ahmeteminaydin/comet/src/g5.js

G.peak = {name:"Peak-hold / pulse height (extra)", group:"Analog chain", k:"ana",
 summary:"The peak-hold is an extra feature that measures how big each muon pulse is. It captures the highest voltage of the shaped AFE pulse and holds it long enough for the microcontroller's ADC to read it. A histogram of these heights shows the Landau distribution, the characteristic shape of energy loss by a charged particle in a thin layer.",
 io:["The shaped AFE pulse from the slow branch","A held voltage equal to the pulse peak, read by the MCU ADC as a 12-bit code (hA or hB)"],
 how:[
  "Why pulse height is interesting. Muons crossing 1 cm of plastic do not all lose exactly 2 MeV. Most lose close to the most probable value, but now and then one knocks out an energetic electron and loses much more. The resulting distribution has a peak and a long tail toward high energy, called the Landau distribution. Seeing this shape proves that the counted pulses really come from minimum ionizing particles, and the position of the peak tracks the SiPM gain over time.",
  "How a peak detector works. An op-amp charges a small capacitor through a diode. While the input rises, the op-amp charges the capacitor to follow it. When the input falls, the diode blocks, so the capacitor keeps the highest voltage reached. A buffer amplifier copies the capacitor voltage to the ADC without draining it.",
  "Forgetting old pulses. A plain peak detector keeps the largest pulse since it was last emptied, which could be an unrelated single from seconds ago. The baseline therefore puts a bleed resistor across the capacitor so the held voltage decays with a time constant of about 20 µs. Singles arrive tens of milliseconds apart, so an old pulse has fully decayed before the next event, while the current pulse loses only a few percent in the 1 µs before it is sampled. Because the sampling delay is always the same, that small loss is the same for every event and is removed by calibration.",
  "Timing. The coincidence latch tells the microcontroller that an event happened. The firmware waits a fixed 1 µs for the shaped pulse to reach its peak, converts both channels with the ADC, and then empties the capacitors by raising PEAK_RST for at least 200 ns. The sequence takes a few microseconds, which is negligible at about 12 events per minute.",
  "Why the reset goes through a resistor. SW1 drains C20 through R18 (100 Ω) rather than shorting it. If SW1 shorted C20 directly, U10 would try to pull the hold node back up to its input, push its full output current (tens of milliamps) through D1 into the switch, and end up stuck at its positive limit. When the switch opened, the saturated op-amp would dump extra charge into C20 and the next reading would start too high: in simulation the ADC then read 0.78 V instead of the 0.30 V baseline. With R18, C20 falls to the baseline within about 50 ns, U10 simply holds it there with about 3 mA, and nothing overshoots when the switch opens."],
 conn:[["From","The AFE output through the CR-RC shaping stage."],["To","An MCU ADC input (ADC ← peak A and ADC ← peak B on the schematic)."],["Control (optional)","A reset line from an MCU GPIO pin to an analog switch across the hold capacitor."]],
 specs:["Analog peak-hold or fast sampling to reconstruct the Landau distribution (extra feature)","Held value a fixed few percent below the peak (about −6 % in simulation, removed by calibration), linear for pulses up to about 1.4 V above the 0.3 V baseline","Decay time constant ≈ 20 µs so old pulses are forgotten","Sampled at a fixed delay of ≈ 1 µs after the coincidence latch; reset back to the baseline within 200 ns"],
 steps:[
  ["Simulate the peak detector","In LTspice, build the op-amp, Schottky diode (BAT54), hold capacitor (start with 470 pF), bleed resistor and buffer, and feed it the shaped AFE pulse. Check that the value 1 µs after the pulse is a fixed few percent below the pulse peak for pulses up to about 1.4 V above the 0.3 V baseline. Larger pulses pass the OPA356's input limit (1.8 V on a 3.3 V supply) and clip, which only affects the far end of the Landau tail."],
  ["Choose the capacitor and bleed resistor","Pick the capacitor and resistor so that their product is about 20 µs, for example 470 pF and 43 kΩ. Check in simulation that the capacitor still charges fully during the rising edge of the pulse; if not, use a smaller capacitor and a larger resistor."],
  ["Add the reset switch","Place a TS5A3159 analog switch from the hold capacitor to ground through R18 = 100 Ω, and drive it from the PEAK_RST pin of the MCU with a 100 kΩ pull-down (R39) so it stays open while the MCU is in reset. Power the switch's V+ pin from +3V3 so the 3.3 V logic line can drive it. The firmware can then empty the capacitor right after reading, which helps when two events come close together."],
  ["Connect and time the ADC","Wire each buffer output to an ADC input. In the coincidence interrupt, wait a fixed 1 µs after the latch, convert both channels, then raise PEAK_RST for at least 200 ns. Use exactly the same delay for every event."],
  ["Calibrate","Inject pulses of known amplitude at the AFE input and record the ADC codes. Fit a straight line from code to amplitude and use it to label the histogram axis."],
  ["Build the histogram","In the GUI, histogram hA and hB for all coincidence events. After a few thousand events the Landau shape with its long tail should appear."]],
 parts:[["Op-amp","OPA356 (U10) on +3V3_A","Charges the hold capacitor quickly; on the 3.3 V analog rail it can never drive the ADC above 3.3 V."],
  ["Diode","BAT54 Schottky","Low forward voltage and fast switching."],
  ["Hold network","470 pF C0G capacitor with a 43 kΩ bleed resistor","Holds the peak for about 20 µs and then forgets it."],
  ["Reset","TS5A3159 analog switch, R18 100 Ω, R39 100 kΩ pull-down","Empties the capacitor on command without fighting U10."],
  ["Buffer","OPA356 (U11) as a unity-gain buffer","CMOS inputs with picoamp bias current, so it does not drain the capacitor."]],
 test:[["Linearity","Inject pulses of increasing size at the AFE input. Reading minus baseline against pulse height should be a straight line up to about 1.4 V at the shaper output."],
  ["Reset","Trigger a reading followed by PEAK_RST. Right after the reset the ADC must read the 0.30 V baseline, not a value above it."],
  ["Old pulses forgotten","Fire a large test pulse, then a small one 1 ms later. The second reading must match the small pulse, not the large one."],
  ["Landau shape","After about 2,000 muon events, the histogram should show a clear peak and a long tail toward large heights, with noise only at the very low end."]],
 pitfalls:[["Holding the wrong pulse","Without the bleed resistor or a reset, the circuit keeps the largest pulse since the last reset, which may be an unrelated single. Always make it forget old pulses."],
  ["Leakage","Leakage in the diode and input current of the buffer make the held voltage drift. Choose low-leakage parts and always sample at the same delay."],
  ["Pile-up","If two pulses arrive within a few microseconds, the measured height is wrong. The firmware can flag events where a second single arrived during the hold time."]],
 terms:[["Landau distribution","The asymmetric distribution of energy lost by a fast charged particle in a thin layer: a peak with a long tail toward high energy."],
  ["Peak detector","A circuit that follows a rising signal and holds its maximum."],
  ["Droop","The slow fall of a held voltage caused by leakage or a bleed resistor."]]};

G.thr = {name:"Threshold DAC", group:"Analog chain", k:"ana",
 summary:"The threshold DAC sets the voltage each comparator compares the pulse against. A threshold that is too low lets noise and dark counts through, and one that is too high throws away real muons. Because the microcontroller sets it, the team can scan thresholds and set the two channels independently.",
 io:["A threshold value from the MCU over I²C","Two reference voltages, one per comparator, equal to the AFE baseline plus the chosen threshold"],
 how:[
  "What the threshold does. The comparator outputs a logic pulse only while the AFE output is above the threshold voltage. Dark counts give about 1.6 mV per photoelectron at TP2 (a few millivolts when crosstalk fires neighbouring cells), gammas give anything from a few to hundreds of millivolts, and a typical muon gives about 0.23 V (simulation of the baseline design). The threshold should sit well above the dark-count level but well below the muon pulses.",
  "Choosing the value. In the baseline one photoelectron is about 1.6 mV at TP2, so a threshold of 120 mV above the baseline corresponds to roughly 75 photoelectrons. That is far above dark-count pile-up and about half of a typical muon pulse. The light yield of 140 photoelectrons is only an estimate, so the final value comes from a threshold scan: you measure the count rate at many thresholds and choose a point on the flatter part of the curve, where small threshold changes barely change the rate.",
  "Threshold relative to the baseline. The AFE baseline sits at about 0.3 V, so the comparator reference is the baseline plus the threshold, for example 0.300 + 0.120 = 0.420 V (DAC code 840). The firmware stores thresholds as millivolts above the baseline and adds the baseline when it sets the DAC.",
  "Why a DAC. A quad DAC (MCP4728) gives four outputs from one small chip: threshold A, threshold B, a spare, and the bias setting (VOUTD, halved onto the LT3482's CTRL pin). It has a built-in 2.048 V reference, so each step is 0.5 mV. It can also keep codes in its EEPROM, but from the factory these are 0: after power-up the thresholds sit at 0 V, below the baseline, so the comparators stay on, and the bias is off until the firmware writes its codes."],
 conn:[["From","The MCU over I²C (MCP4728 default address 0x60)."],["To","The − input of each comparator, through a 1 kΩ / 100 nF RC filter."],["Shares the chip with","The bias setting used by the temperature compensation (DAC channel D → R22/R36 → LT3482 CTRL)."]],
 specs:["Adjustable comparator threshold in each module (spec)","Step size 0.5 mV (12-bit with the 2.048 V internal reference)","Thresholds A and B set independently","Settings kept in the DAC's memory and in MCU flash"],
 steps:[
  ["Prototype with potentiometers","For the first prototype, use a 10-turn trimmer potentiometer per channel between 3.3 V and ground, with the wiper filtered by 1 kΩ and 100 nF. This lets you test the analog chain before any firmware exists."],
  ["Wire the DAC","On the baseboard, place the MCP4728 near the comparators, power it from 3.3 V, connect SDA and SCL to the MCU I²C bus with 4.7 kΩ pull-ups, and select its internal 2.048 V reference. Output A goes to comparator A, output B to comparator B, and output D to the bias CTRL divider. Tie LDAC̅ low so the outputs update as soon as each write finishes."],
  ["Filter at the comparator","Put a 1 kΩ resistor and a 100 nF capacitor right at each comparator's − input, so digital noise picked up on the DAC line cannot move the threshold."],
  ["Write the commands","Add firmware commands such as THR A 120 and THR B 120, in millivolts above the baseline. The firmware adds the baseline (measured at start-up or the design value of 0.3 V), converts to a DAC code and writes it. Save the values to flash."],
  ["Run a threshold scan","For each channel, step the threshold from 20 mV to 800 mV in roughly 20 mV steps and count singles for 30 seconds at each step. Plot the rate against threshold with a logarithmic rate axis. You will see a steep fall at low thresholds (noise and dark counts), a gentler slope (gammas), and a shoulder where the muon pulses sit. Choose a threshold just above the steep part, and set the two channels so they give similar singles rates."],
  ["Repeat after changes","Repeat the scan whenever the bias, a SiPM or the optical coupling changes."]],
 parts:[["DAC","Microchip MCP4728 quad 12-bit DAC","Four outputs, internal reference and settings memory in one small chip."],
  ["Prototype","10-turn trimmer potentiometers","Quick bring-up without firmware."],
  ["Filter","1 kΩ resistor and 100 nF capacitor per channel","Keeps the threshold quiet at the comparator."],
  ["I²C pull-ups","2 × 4.7 kΩ to 3.3 V","Needed once for the whole I²C bus."]],
 test:[["DAC output","Command several thresholds and measure the comparator − pin with a multimeter. It should equal baseline plus threshold within about 2 mV."],
  ["Threshold scan shape","The scan should show a steep fall and then a much flatter region. If the rate never flattens, there is a noise problem or a light leak."],
  ["Channel balance","At the chosen thresholds, the singles rates of A and B should agree within about 20 %."]],
 pitfalls:[["Ground offsets","If the DAC and the comparator use different ground points, a few millivolts of ground difference shift the threshold. Return both to the same analog ground."],
  ["Forgetting the baseline","Setting the DAC to 120 mV when the baseline is 300 mV puts the reference below the baseline, so the comparator stays on permanently. Always add the baseline."],
  ["Threshold on the steep part","A threshold on the steep part of the scan makes the rate very sensitive to small gain changes. Stay on the flatter part."]],
 terms:[["Threshold scan","A measurement of count rate against threshold, used to choose the operating point."],
  ["DAC","Digital-to-analog converter, which turns a number from the MCU into a voltage."],
  ["Plateau","The flatter region of a threshold scan, where the rate changes slowly."]]};
