ahmeteminaydin/comet/src/g7.js

G.coinc = {name:"Coincidence logic (AND + latch)", group:"Timing logic", k:"dig", tool:"acc",
 summary:"The coincidence logic decides whether both modules fired at the same time. An AND gate combines the two stretched pulses, and a flip-flop catches its output and holds it until the microcontroller has read it. Every event that reaches the PC as an EVT line starts here.",
 io:["Stretched pulses A and B, 50 ns each","A latched coincidence signal for the MCU's timer input (TP5)"],
 how:[
  "The AND gate. A 74LVC1G08 outputs 3.3 V only when both inputs are high. Its inputs are the two 50 ns stretched pulses, so its output goes high only when the pulses overlap, which means the two slabs fired less than 50 ns apart. The gate adds a delay of only a few nanoseconds.",
  "Why a latch is needed. If the two pulses only just overlap, the AND output can be a few nanoseconds long. The microcontroller could miss such a short pulse, and it needs time to respond anyway. The AND output therefore clocks a 74LVC1G74 D flip-flop whose D input is tied high: on the rising edge, Q goes high and stays high. Q is wired to a timer input-capture pin on the MCU, which records the exact time, and the firmware clears the flip-flop through its CLR pin once it has handled the event.",
  "Dead time. While the flip-flop is set and the firmware is handling the event, another coincidence would be missed. The firmware handles an event in well under 50 µs and coincidences arrive about every 5 seconds, so the chance of missing one is about 1 in 100,000.",
  "Accidental coincidences. Two unrelated hits, one in each slab, can fall into the window by chance. Their rate is R_acc = (w_A + w_B) × R_A × R_B. With 40 Hz singles in each channel and a 100 ns window this is about 0.01 per minute, roughly a thousand times smaller than the muon rate. It is still subtracted in the analysis (see the data logger guide), and the calculator below shows how quickly it grows if the singles rates rise.",
  "Singles counting. Each stretched pulse also goes to a hardware counter in the MCU. These singles counts are needed for the accidental correction and help to spot light leaks and threshold problems."],
 conn:[["From","Stretched pulses A and B (TP4)."],["To","An MCU timer input-capture pin and its interrupt (CAPTURE ← coinc, TP5)."],["Control","An MCU GPIO pin to the flip-flop's CLR input, and an optional MCU test-pulse output into both channels."]],
 specs:["Hardware coincidence with a window ≤ 100 ns (spec)","Accidental rate < 0.1 /min in horizontal or non-aligned orientation (spec)","Gate and latch delays of a few ns","Latch cleared by the MCU after every event, with a timeout as a safety net"],
 steps:[
  ["Place the gate and latch","Put the 74LVC1G08 and the 74LVC1G74 close together between the two stretchers, powered from 3.3 V with a 100 nF capacitor at each chip. Make the traces from the two stretchers to the AND inputs about equal in length."],
  ["Wire the latch","Connect the AND output to the flip-flop's clock input, tie D and PRE̅ (preset, active low) to +3V3, connect Q to an MCU timer channel set up for input capture (TIM2), and connect CLR̅ (active low) to the LATCH_CLR pin of the MCU with a 10 kΩ pull-up (R37). The pull-up keeps the latch armed while the MCU's pins are still inputs after a reset."],
  ["Count singles in hardware","Also connect each stretched pulse to an MCU timer used as an external counter (channel 1 of TIM3 and TIM4, in external clock mode 1, on the STM32). Hardware counters never miss a pulse, even when the firmware is busy."],
  ["Add a test-pulse path","Connect the TEST_PULSE output of the MCU to each AFE input through 18 pF in series with 12 kΩ (C14/R33 for A, C15/R34 for B), with a 100 kΩ pull-down (R38) so the line stays low during reset. A 3.3 V step then injects about 59 pC that decays with τ = 216 ns, which looks like a real muon at the AFE input (about 14 mV at TP1) instead of a fast spike. Hold TEST_PULSE high for at least 1 µs, because its falling edge injects an equal negative pulse. This tests the whole chain without muons and is very useful when debugging."],
  ["Write the firmware side","In the capture interrupt: read the captured timestamp, trigger the peak-hold ADC, read the singles counters, clear the latch and put a record into the ring buffer. Keep the interrupt short."],
  ["Check the widths with the calculator","Enter your measured singles rates into the calculator below and confirm that the accidental rate stays well below 0.1 per minute."]],
 parts:[["AND gate","74LVC1G08","Single 2-input AND gate, a few ns delay."],
  ["Latch","74LVC1G74","Single D flip-flop with clear and preset inputs."],
  ["Any-hit (optional)","74LVC1G32","An OR gate, if you later want to trigger on either channel for single-module spectra."]],
 test:[["Window with a generator","Feed pulses from a two-channel function generator into the stretcher inputs and sweep the delay between the channels. The latch should fire for delays between about −50 and +50 ns and never outside that range."],
  ["Coincidence proof","Stack the modules and count for 10 minutes, then move one module sideways out of line and count again. The rate should drop from about 12 per minute to almost zero."],
  ["Accidental test (spec)","With the telescope horizontal or the modules side by side, run for at least an hour. Fewer than 0.1 coincidences per minute are allowed."]],
 pitfalls:[["Ground bounce","Fast edges in nearby logic cause small ground shifts that can look like pulses. Keep a decoupling capacitor at every chip and keep traces short."],
  ["A slow interrupt","Long work inside the interrupt adds dead time. Do only the essential steps there and the rest in the main loop."],
  ["Forgetting to clear","If the firmware does not clear the latch, it stays set and no more events are recorded. Clear it in every interrupt and add a timeout that clears it anyway."]],
 terms:[["AND gate","A logic gate whose output is high only when all of its inputs are high."],
  ["Latch (flip-flop)","A circuit that stores one bit until it is cleared."],
  ["Dead time","The time after an event during which the system cannot record another one."],
  ["Input capture","A timer feature that copies the timer value into a register at the moment a pin changes."]]};

G.mcu = {name:"Microcontroller DAQ", group:"Acquisition", k:"dat",
 summary:"The microcontroller (MCU) is the data acquisition system. It timestamps every coincidence, counts singles in hardware, reads pulse heights, temperatures and the bias voltage, sets the thresholds and the bias, and sends everything to the PC as lines of text over USB. The baseline is an STM32G431, prototyped on a Nucleo-G431KB board.",
 io:["Latched coincidence, singles pulses, ADC inputs and I²C sensors","EVT and STAT text lines over USB, and settings for the DACs"],
 how:[
  "Timestamps. A 32-bit timer (TIM2) counts at 1 MHz, so each tick is 1 µs. When the coincidence latch goes high, the timer's input-capture hardware copies the current count into a register at that instant, so the timestamp is exact even if the interrupt starts a little later. The 32-bit count wraps around after 71.6 minutes, so the firmware counts the wrap-arounds and combines them into a 64-bit microsecond time that never wraps.",
  "Hardware counters. Two other timers, TIM3 and TIM4, count pulses arriving on their channel-1 pins (external clock mode 1). The stretched pulses of channels A and B are wired to these pins, so every single is counted by hardware without any firmware involvement. These 16-bit counters overflow after 65,536 counts, about every 27 minutes at 40 Hz, so the firmware extends them as well.",
  "Data format. Every coincidence produces one text line: EVT,seq,t_us,A,B,C,hA,hB,T_C,Vbias. Here seq increases by one with every event; t_us is the 64-bit timestamp in microseconds; A, B and C are flags (always 1,1,1 in coincidence mode, kept for a possible single-channel mode later); hA and hB are the 12-bit peak-hold codes, or 0 if the peak-hold is not fitted; T_C is the average SiPM temperature in °C; and Vbias is the measured bias in volts. Once per second the MCU also sends STAT,t_us,nA=…,nB=…,nC=…,T=…,Vb=…, with the singles and coincidence counts accumulated since START.",
  "Buffering. The interrupt never waits for USB. It writes the event into a ring buffer in RAM (256 records is plenty), and the main loop sends lines from the buffer whenever USB is ready. If the buffer ever fills, the firmware counts the lost records and reports the number in the STAT line rather than freezing.",
  "Power-up. After a reset every MCU pin is an input, and the MCP4728 starts from its EEPROM codes, which are 0 from the factory. Pull resistors keep the board in a safe state until the firmware runs: R37 keeps the coincidence latch armed, R38 keeps TEST_PULSE low, R39 keeps the peak-hold switch open, and DAC code 0 keeps the SiPM bias off. The firmware then writes the thresholds and ramps the bias up to its working value in small steps.",
  "Commands. The PC can send simple text commands: START and STOP; THR A 120 and THR B 120 for thresholds in mV above the baseline; OV 2.5 for the overvoltage; COMP 1 or COMP 0 to switch temperature compensation on or off; and STATUS to report the current settings."],
 conn:[["Inputs","Coincidence latch (input capture); singles A and B (counter inputs); peak-hold A and B, bias voltage and bias current (ADC); I²C bus with two TMP117s, the MCP4728 and an optional accelerometer."],["Outputs","Latch clear, peak-hold reset and test pulse (GPIO pins); USB data to the PC."],["Power","3.3 V from the low-noise LDO."]],
 specs:["Records individual channel counts, coincidence events and timestamps (spec)","Delivers structured data to a computer for real-time monitoring and logging (spec)","Timestamp resolution 1 µs, extended to 64 bits","Dead time per event < 50 µs; singles counted in hardware"],
 steps:[
  ["Start on the Nucleo board","Buy a Nucleo-G431KB and develop the firmware on it while the baseboard is being designed. It has the same microcontroller plus a built-in programmer and debugger. At first you can send data through the board's built-in virtual COM port (the ST-LINK UART) and switch to native USB later on the baseboard."],
  ["Set up the project","Use STM32CubeIDE with its pin configurator. Enable TIM2 at 1 MHz with one input-capture channel, TIM3 and TIM4 in external clock mode 1 clocked from their CH1 pins, ADC1 with the channels you need, I²C1 at 100 kHz, the USB device in CDC (virtual COM port) mode, and GPIO pins for latch clear, peak reset and test pulse."],
  ["Write the interrupt","In the input-capture interrupt: read the captured time and extend it to 64 bits, wait the fixed 1 µs and read both peak-hold channels, read the singles counters, pulse the latch clear and peak reset, and push one record into the ring buffer."],
  ["Write the main loop","Send buffered records as EVT lines, send a STAT line every second, run the temperature compensation every second, and handle incoming commands."],
  ["Test with a generator","Before connecting detectors, feed a function generator into the latch and counter inputs and check that counts, rates and timestamps are exactly right."],
  ["Measure the dead time","Toggle a spare GPIO at the start and end of the interrupt and measure the high time on the oscilloscope. It should be well under 50 µs."],
  ["Move to the baseboard","On the baseboard keep the same pin assignments, add an 8 MHz crystal for accurate timing and an SWD header for programming, and connect the MCU's native USB pins to the USB-C connector."]],
 parts:[["MCU","ST STM32G431 (STM32G431KB for the baseboard)","Fast timers, ADC, I²C and USB device in one inexpensive chip."],
  ["Prototype board","Nucleo-G431KB","Same chip with programmer and debugger, about the size of a USB stick."],
  ["Clock","8 MHz crystal","Accurate timestamps; USB can also run from the internal 48 MHz oscillator."],
  ["Tools","STM32CubeIDE (free)","Pin configuration, compiler and debugger in one package."]],
 test:[["Known pulse train","Feed 100 Hz into a singles input for 60 s. The STAT count must increase by exactly 6,000."],
  ["Timestamps","Feed a 1 Hz pulse into the latch input. Successive EVT timestamps must be 1,000,000 µs apart, within the generator's accuracy."],
  ["Long run","Run for at least two hours, past the 71.6-minute wrap-around, and check that the sequence numbers have no gaps and the timestamps keep increasing."]],
 pitfalls:[["Blocking on USB","If the PC program stops reading, USB transmission can stall. Never wait for USB inside the interrupt; use the ring buffer and count drops."],
  ["Wrap-around bugs","Mistakes in extending the 32-bit timer or the 16-bit counters only show up after 71.6 or about 27 minutes. Test long runs early."],
  ["Floating inputs","Unconnected timer or GPIO inputs pick up noise and produce fake counts. Give unused inputs pull-down resistors."]],
 terms:[["DAQ","Data acquisition: measuring and recording signals."],
  ["Ring buffer","A fixed-size memory queue in which writing and reading go round in a circle."],
  ["CDC","USB Communications Device Class; the board appears as a serial (COM) port on the PC."],
  ["Interrupt","A hardware signal that makes the processor pause and run a short routine immediately."]]};
