ahmeteminaydin/comet/(commit log)

2026-11-10 Add COMET interactive system schematic
    Claude-Session: https://claude.ai/code/session_01WnuoBqtTXFkssxRM3aBAvM
2026-11-10 Add LTspice schematic of the channel A front-end
    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
2026-11-12 Add in-browser SPICE simulation and LTspice downloads for every circuit sheet
    - Detail sheets now record an electrical model while drawing; the netlist,
    the browser simulation and the LTspice schematic are all derived from it.
    - ngspice (WebAssembly, eecircuit-engine 1.9.0) runs in the page: click a
    part value to edit it, run, see waveforms and spec checks, run sweeps.
    - sim/<sheet>/ holds an LTspice .zip (schematic, symbols, models) and a
    standalone .cir for each of the eight circuit sheets.
    - New SiPM microcell model: ~14 mV, ~220 ns pulse at TP1; guide numbers updated.
    - Threshold codes corrected for the 312.5 mV baseline; stretcher timing set to 50 ns.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
    [build.py]
2026-11-12 Bias sheet: output now regulates on R20/R21/R22; fix edited-value styling
    - TP7 is driven by an ideal regulator holding FB at the LT3482's 1.235 V
    reference, so feedback and trim resistor edits change the SiPM bias.
    - New checks: set point, DC bias at the SiPM, overvoltage (1-5 V).
    - R21 = 48.1 kOhm gives 27.0 V at mid-scale trim.
    - Edited values no longer inherit a dashed stroke from the rate-chart CSS,
    drop the approximate markers, and parts have larger click areas.
    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
    [spice_cfg.js]
2026-11-13 Design review of every sheet and simulation
    Errors fixed in the schematics
    - AFE: LMH6629 replaced by OPA356 (it could not swing to the 0.3 V
    baseline); all op-amps on +3V3_A so nothing can exceed the 3.3 V
    comparator and ADC; baseline from the regulated rail (R2/R3 = 0.300 V);
    shaper returned to VB with gain 6.1.
    - Bias: LT3482 redrawn from the datasheet (CTRL, FSET, MONIN, APD, VOUT1,
    PUMP, internal diodes, R35 on MON, SiPMs fed through the monitor);
    bias set through the CTRL pin (VOUT2 = 34.1 x V_CTRL, off at code 0);
    R20/R21 load the converter against pulse skipping.
    - Stretcher: flip-flop one-shot replaces the 74LVC1G123, which cannot make
    50 ns; PRE and D tied high. Comp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
    [build.py, g5.js]
